NathanHowell/orin-nano-controller/pcb/orin-nano-controller.kicad_pcb

## KiCad design pcb/orin-nano-controller.kicad_pcb (2025-10-23)

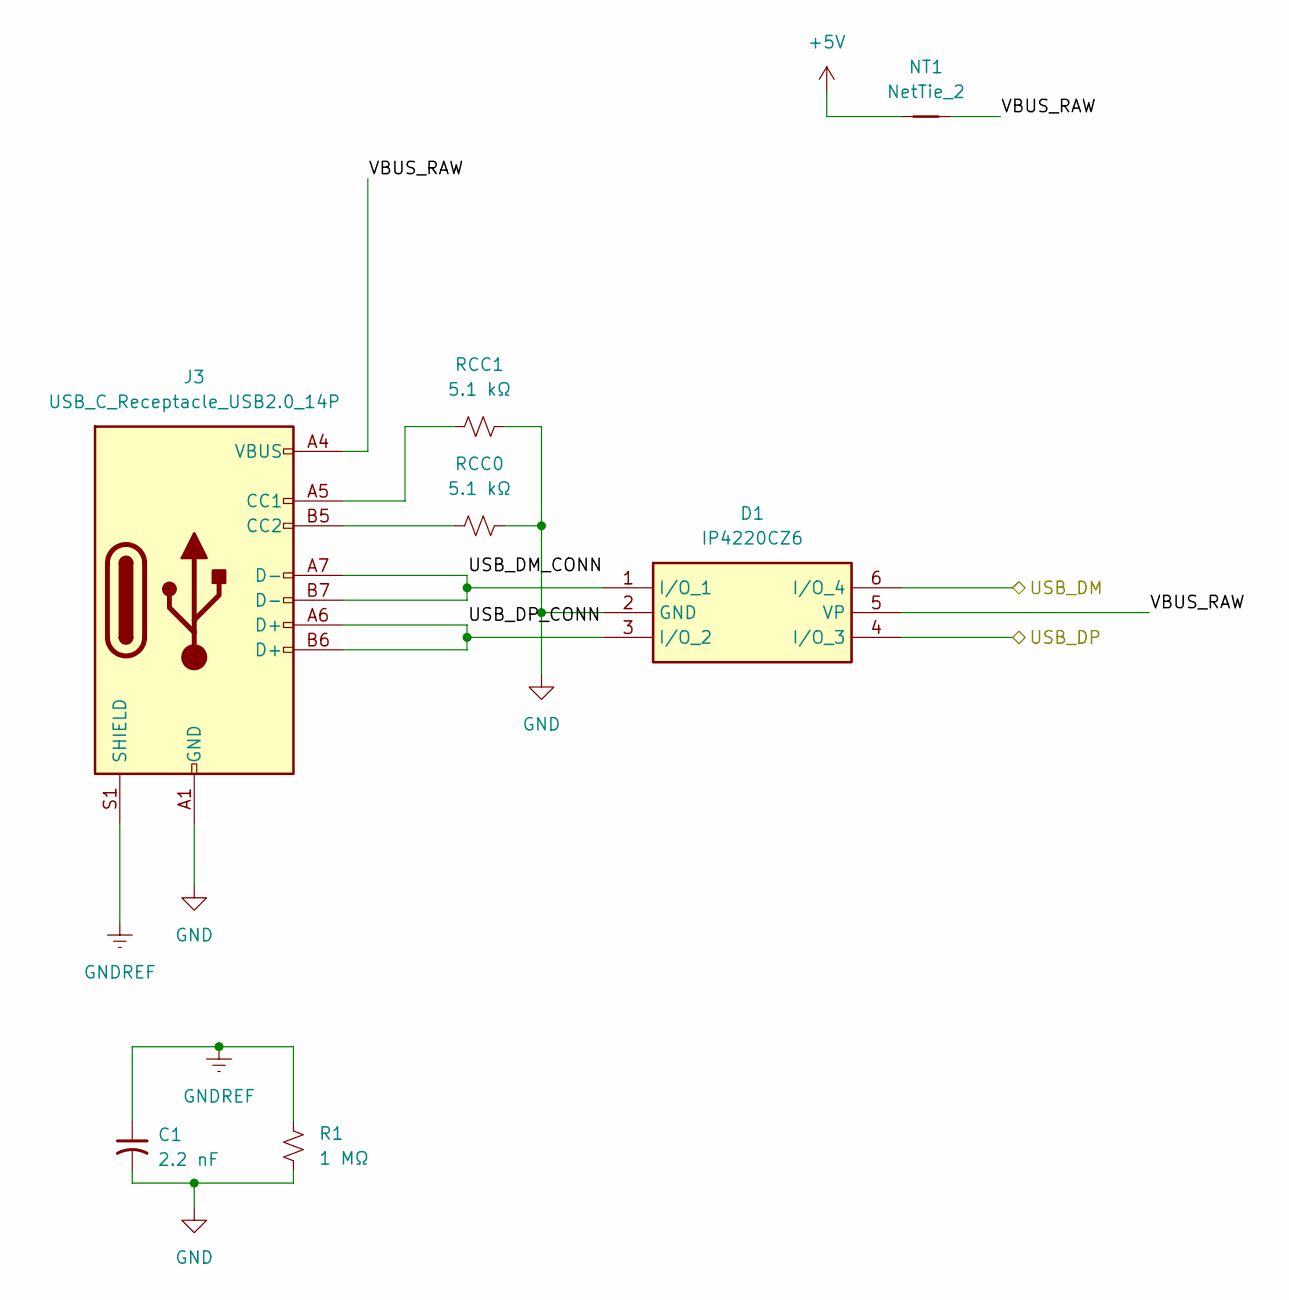
[picture p1: schematic usb.kicad_sch, Frontend]

Parts:
C1: 2.2 nF; C_0805_2012Metric_Pad1.18x1.45mm_HandSolder
D1: IP4220CZ6; Manufacturer_Part_Number IP4220CZ6; Mouser Part Number N/A
J3: USB_C_Receptacle_USB2.0_14P; USB_C_Receptacle_GCT_USB4085
NT1: NetTie_2; NetTie-2_SMD_Pad0.5mm
R1: 1 MΩ; R_0805_2012Metric_Pad1.20x1.40mm_HandSolder
RCC0, RCC1: 5.1 kΩ; R_0805_2012Metric_Pad1.20x1.40mm_HandSolder

Connections:
+5V: NT1.2; also elsewhere on the board
/Controller/USB_DM: D1.6 (I/O_4); also elsewhere on the board
/Controller/USB_DP: D1.4 (I/O_3); also elsewhere on the board
/Frontend/USB_DM_CONN: D1.1 (I/O_1), J3.A7 (D-), J3.B7 (D-)
/Frontend/USB_DP_CONN: D1.3 (I/O_2), J3.A6 (D+), J3.B6 (D+)
/Frontend/VBUS_RAW: D1.5 (VP), J3.A4 (VBUS), J3.A9 (VBUS), J3.B4 (VBUS), J3.B9 (VBUS), NT1.1
GND: C1.2, D1.2 (GND), J3.A1 (GND), J3.A12 (GND), J3.B1 (GND), J3.B12 (GND), R1.2, RCC0.2, RCC1.2; also elsewhere on the board
GNDREF: C1.1, J3.S1 (SHIELD), R1.1
unnamed: J3.A5 (CC1), RCC1.1
unnamed: J3.B5 (CC2), RCC0.1

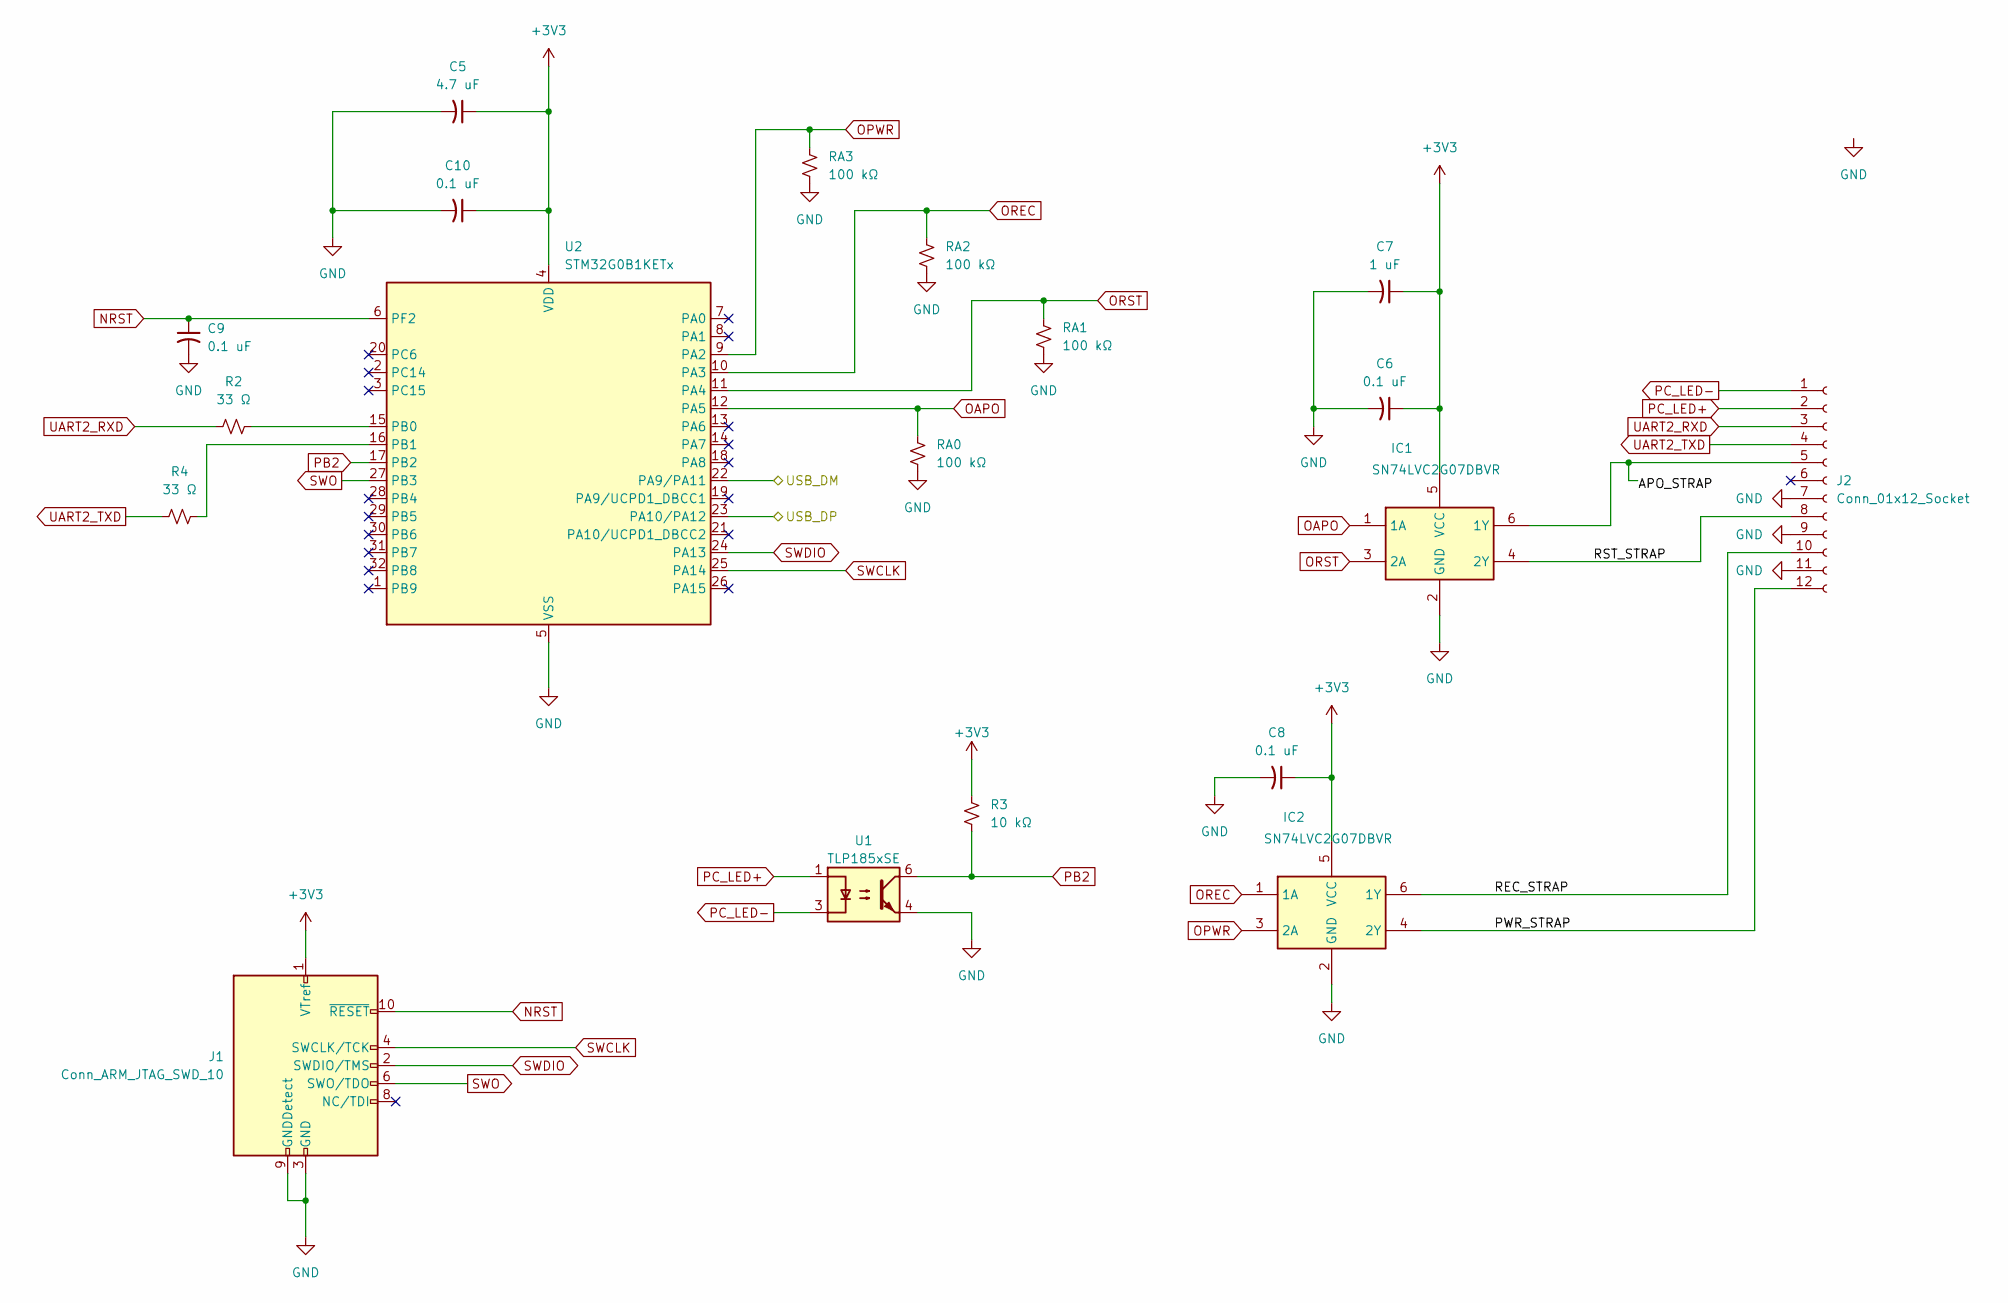
[picture p2: schematic controller.kicad_sch]

Parts:
C5: 4.7 uF; C_0805_2012Metric_Pad1.18x1.45mm_HandSolder
C6, C8: 0.1 uF; C_0805_2012Metric_Pad1.18x1.45mm_HandSolder
C7: 1 uF; C_0805_2012Metric_Pad1.18x1.45mm_HandSolder
C9, C10: 0.1 uF; C_0603_1608Metric_Pad1.08x0.95mm_HandSolder
IC1, IC2: SN74LVC2G07DBVR; SOT95P280X145-6N; Manufacturer_Part_Number SN74LVC2G07DBVR; Mouser Part Number 595-SN74LVC2G07DBVR
J1: Conn_ARM_JTAG_SWD_10; PinHeader_2x05_P1.27mm_Vertical
J2: Conn_01x12_Socket; PinSocket_1x12_P2.54mm_Horizontal
R2, R4: 33 Ω; R_0805_2012Metric_Pad1.20x1.40mm_HandSolder
R3: 10 kΩ; R_0805_2012Metric_Pad1.20x1.40mm_HandSolder
RA0, RA1, RA2, RA3: 100 kΩ; R_0805_2012Metric_Pad1.20x1.40mm_HandSolder
U1: TLP185xSE; SOIC-4_4.55x3.7mm_P2.54mm
U2: STM32G0B1KETx; LQFP-32_7x7mm_P0.8mm

Connections:
+3V3: C5.1, C6.1, C7.1, C8.1, C10.1, IC1.5 (VCC), IC2.5 (VCC), J1.1 (VTref), R3.1, U2.4 (VDD); also elsewhere on the board
/Controller/APO_STRAP: IC1.6 (1Y), J2.5
/Controller/PWR_STRAP: IC2.4 (2Y), J2.12
/Controller/REC_STRAP: IC2.6 (1Y), J2.10
/Controller/RST_STRAP: IC1.4 (2Y), J2.8
/Controller/USB_DM: U2.22 (PA9/PA11); also elsewhere on the board
/Controller/USB_DP: U2.23 (PA10/PA12); also elsewhere on the board
GND: C5.2, C6.2, C7.2, C8.2, C9.2, C10.2, IC1.2 (GND), IC2.2 (GND), J1.3 (GND), J1.5 (GND), J1.9 (GNDDetect), J2.7, J2.9, J2.11, RA0.2, RA1.2, RA2.2, RA3.2, U1.4, U2.5 (VSS); also elsewhere on the board
NRST: C9.1, J1.10 (~RESET), U2.6 (PF2)
unnamed: R2.2, U2.15 (PB0)
unnamed: R4.2, U2.16 (PB1)
OAPO: IC1.1 (1A), RA0.1, U2.12 (PA5)
OPWR: IC2.3 (2A), RA3.1, U2.9 (PA2)
OREC: IC2.1 (1A), RA2.1, U2.10 (PA3)
ORST: IC1.3 (2A), RA1.1, U2.11 (PA4)
PB2: R3.2, U1.6, U2.17 (PB2)
PC_LED+: J2.2, U1.1
PC_LED-: J2.1, U1.3
SWCLK: J1.4 (SWCLK/TCK), U2.25 (PA14)
SWDIO: J1.2 (SWDIO/TMS), U2.24 (PA13)
SWO: J1.6 (SWO/TDO), U2.27 (PB3)
UART2_RXD: J2.3, R2.1
UART2_TXD: J2.4, R4.1

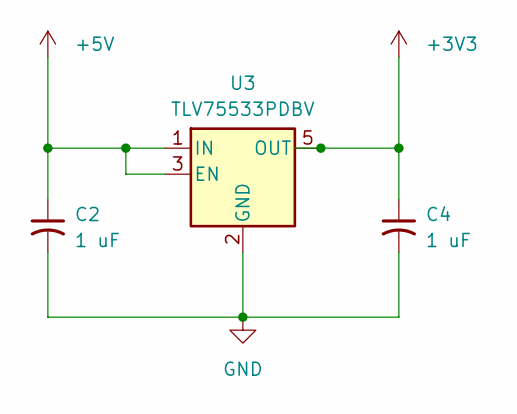
[picture p3: schematic power.kicad_sch]

Parts:
C2, C4: 1 uF; C_0805_2012Metric_Pad1.18x1.45mm_HandSolder
U3: TLV75533PDBV; SOT-23-5

Connections:
+3V3: C4.1, U3.5 (OUT); also elsewhere on the board
+5V: C2.1, U3.1 (IN), U3.3 (EN); also elsewhere on the board
GND: C2.2, C4.2, U3.2 (GND); also elsewhere on the board

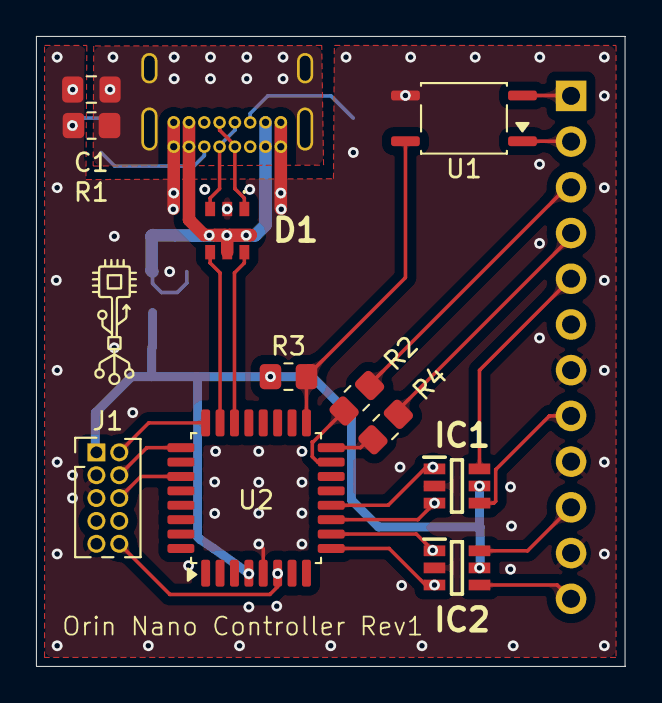
[picture p4: board orin-nano-controller.kicad_pcb from above]

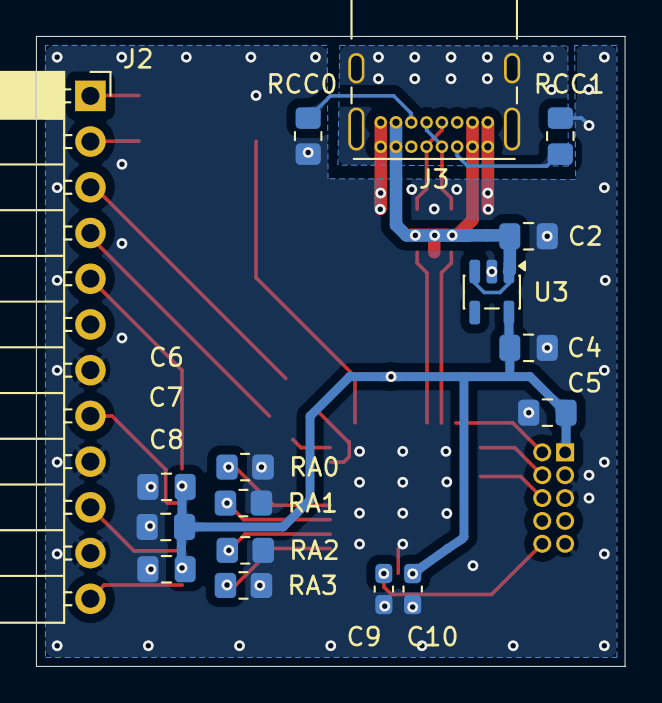
[picture p5: board orin-nano-controller.kicad_pcb from below]

Board: 4 copper layers, 32.7 x 35.0 mm, 29 parts (18 on the bottom side), 30 nets.
