NathanHowell/orin-nano-controller/(commit log)

2025-10-16 Initial add
    [controller.kicad_sch, orin-nano-controller.kicad_pcb, orin-nano-controller.kicad_sch, power.kicad_sch, straps.kicad_sch, usb.kicad_sch]
2025-10-21 remove some vias
    [orin-nano-controller.kicad_pcb]
2025-10-22 rev 1
    [controller.kicad_sch, orin-nano-controller.kicad_pcb, orin-nano-controller.kicad_sch, power.kicad_sch, usb.kicad_sch]
2025-10-23 part updates
    [orin-nano-controller.kicad_pcb]
2025-10-23 replace ldo
    [orin-nano-controller.kicad_pcb, power.kicad_sch]
2025-10-23 update components
    [orin-nano-controller.kicad_pcb]
2025-10-23 refill zones
    [orin-nano-controller.kicad_pcb]
2025-10-24 docs: sync AGENTS with current plan
2025-10-24 T004 pin workspace toolchain
2025-10-24 T005: add strap data model scaffolding
2025-10-24 feat(straps): add orchestrator skeleton scaffolding
2025-10-24 T008: scaffold USB UART bridge channels
2025-10-24 Fix clippy warning for bridge activity monitor
    [mod.rs]
2025-10-25 Wire initial Embassy runtime scaffolding
2025-10-25 Add NormalReboot strap sequence template
2025-10-25 feat(repl): add reboot command with optional delay
    [mod.rs]
2025-10-25 Add normal reboot sequence completion telemetry
    [mod.rs]
2025-10-25 Document rust toolchain pin alignment
2025-10-25 Implement shared strap sequence data structures
2025-10-25 feat(controller-core): add normal reboot sequence
    [mod.rs]
2025-10-25 Implement shared reboot command dispatcher
    [mod.rs]
2025-10-26 Bind strap driver to hardware for normal reboot
    [main.rs]
2025-10-26 Implement emulator reboot session logging
    [main.rs, session.rs]
2025-10-27 Add firmware wiring follow-up tasks
2025-10-27 firmware: drop legacy strap scaffolding
2025-10-27 Wire firmware REPL session plumbing
2025-10-27 Fix host clippy for REPL queues
    [mod.rs]
2025-10-27 feat(firmware): wire jetson uart bridge
2025-10-27 Fix clippy warnings in REPL completion
    [mod.rs]
2025-10-28 Load full strap templates on firmware startup
2025-10-28 T040: resolve clippy warnings
    [mod.rs]
2025-10-28 T063: centralize strap template registration
2025-10-28 T064: share power monitor abstraction
2025-10-28 T066: add VREFINT power monitor
2025-10-28 Fix firmware build entrypoint
    [bridge_task.rs, main.rs, mod.rs]
2025-10-28 T067: add STM32G0 VREFINT sampling helper
2025-10-28 T068: wire firmware to Vrefint power monitor
2025-10-28 Completion: append space via replacement flag
    [main.rs, mod.rs, session.rs, strap_task.rs]
2025-10-28 Move PCB project to pcb root
    [controller.kicad_sch, orin-nano-controller.kicad_pcb, orin-nano-controller.kicad_sch, power.kicad_sch, straps.kicad_sch, usb.kicad_sch]
2025-10-28 Switch REPL lexer to regal
2025-10-29 Use Duration constants in strap sequences
2025-10-29 expose the stm32 serial number through usb
2025-10-29 Fix pedantic clippy violations
    [main.rs, mod.rs]
2025-10-30 Fix emulator completion prefix application
    [session.rs]
